freecores/amber/hw/vlog/system/main_mem.v

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

module main_mem#(
parameter WB_DWIDTH  = 32,
parameter WB_SWIDTH  = 4
)(
input                          i_clk,
input                          i_mem_ctrl,  // 0=128MB, 1=32MB
// Wishbone Bus
input       [31:0]             i_wb_adr,
input       [WB_SWIDTH-1:0]    i_wb_sel,
input                          i_wb_we,
output      [WB_DWIDTH-1:0]    o_wb_dat,
input       [WB_DWIDTH-1:0]    i_wb_dat,
input                          i_wb_cyc,
input                          i_wb_stb,
output                         o_wb_ack,
output                         o_wb_err

);

`include "memory_configuration.v"

reg     [127:0]     ram   [2**(MAIN_MSB-2)-1:0];
wire                start_write;
wire                start_read;
reg                 start_read_d1;
reg                 start_read_d2;
wire    [127:0]     rd_data;
wire    [127:0]     masked_wdata;

reg                 wr_en           = 'd0;
reg     [15:0]      wr_mask         = 'd0;
reg     [127:0]     wr_data         = 'd0;
reg     [27:0]      addr_d1         = 'd0;
wire                busy;
genvar              i;


assign start_write = i_wb_stb &&  i_wb_we && !busy;
assign start_read  = i_wb_stb && !i_wb_we && !busy;
assign busy        = start_read_d1 || start_read_d2;

assign o_wb_err    = 'd0;


generate
if (WB_DWIDTH == 128) 
    begin : wb128
    reg     [127:0]      wb_rdata128 = 'd0;

    // ------------------------------------------------------
    // Write for 32-bit wishbone
    // ------------------------------------------------------
    always @( posedge i_clk )
        begin
        wr_en          <= start_write;
        wr_mask        <= ~ i_wb_sel; 
        wr_data        <= i_wb_dat;

                          // Wrap the address at 32 MB, or full width
        addr_d1        <= i_mem_ctrl ? {5'd0, i_wb_adr[24:2]} : i_wb_adr[29:2];
        
        if ( wr_en )
            ram [addr_d1[27:2]]  <= masked_wdata;
        end


    for (i=0;i<16;i=i+1) begin : masked
        assign masked_wdata[8*i+7:8*i] = wr_mask[i] ? rd_data[8*i+7:8*i] : wr_data[8*i+7:8*i];
        end

        
    // ------------------------------------------------------
    // Read for 32-bit wishbone
    // ------------------------------------------------------
    assign rd_data = ram [addr_d1[27:2]];

    always @( posedge i_clk )
        begin
        start_read_d1   <= start_read;
        start_read_d2   <= start_read_d1;
        if ( start_read_d1 )
            begin
            wb_rdata128 <= rd_data;
            end
        end
    assign o_wb_dat = wb_rdata128 ;                  
    assign o_wb_ack = i_wb_stb && ( start_write || start_read_d2 );

    end
else
    begin : wb32
    reg     [31:0]      wb_rdata32 = 'd0;

    // ------------------------------------------------------
    // Write for 32-bit wishbone
    // ------------------------------------------------------
    always @( posedge i_clk )
        begin
        wr_en          <= start_write;
        wr_mask        <= i_wb_adr[3:2] == 2'd0 ? { 12'hfff, ~i_wb_sel          } : 
                          i_wb_adr[3:2] == 2'd1 ? { 8'hff,   ~i_wb_sel, 4'hf    } : 
                          i_wb_adr[3:2] == 2'd2 ? { 4'hf,    ~i_wb_sel, 8'hff   } : 
                                                  {          ~i_wb_sel, 12'hfff } ; 
        wr_data        <= {4{i_wb_dat}};

                          // Wrap the address at 32 MB, or full width
        addr_d1        <= i_mem_ctrl ? {5'd0, i_wb_adr[24:2]} : i_wb_adr[29:2];
        
        if ( wr_en )
            begin
            ram [addr_d1[27:2]]  <= masked_wdata;
            `ifdef AMBER_MEMIF_DEBUG
            $write("%09d  ", `U_TB.clk_count);
            $display("Main memory write: address %h, data %h, be %d%d%d%d",
                        {2'd0, addr_d1, 2'd0}, wr_data[31:0], 
                        ~wr_mask[addr_d1[1:0]*4+3],
                        ~wr_mask[addr_d1[1:0]*4+2],
                        ~wr_mask[addr_d1[1:0]*4+1],
                        ~wr_mask[addr_d1[1:0]*4+0]                        );
            `endif
            end
        end


    for (i=0;i<16;i=i+1) begin : masked
        assign masked_wdata[8*i+7:8*i] = wr_mask[i] ? rd_data[8*i+7:8*i] : wr_data[8*i+7:8*i];
        end
        
    // ------------------------------------------------------
    // Read for 32-bit wishbone
    // ------------------------------------------------------
    assign rd_data = ram [addr_d1[27:2]];

    always @( posedge i_clk )
        begin
        start_read_d1   <= start_read;
        start_read_d2   <= start_read_d1;
        if ( start_read_d1 )
            begin
            wb_rdata32 <= addr_d1[1:0] == 2'd0 ? rd_data[ 31: 0] :
                          addr_d1[1:0] == 2'd1 ? rd_data[ 63:32] :
                          addr_d1[1:0] == 2'd2 ? rd_data[ 95:64] :
                                                 rd_data[127:96] ;
            end
        end
    assign o_wb_dat = wb_rdata32 ;                  
    assign o_wb_ack = i_wb_stb && ( start_write || start_read_d2 );
    end
endgenerate


endmodule
