freecores/amber/(commit log)

2011-01-19 Corrected a couple of minor typos
2011-02-17 Bug fix - added an extra state to the rx state machine to properly align reading the uart input to the middle of each bit.
    [uart.v]
2011-02-17 Re-wrote the behavioral clock generation code to more accurately calculate the sys_clk frequency. The previous version was not producing the correct frequency at higher frequenies due to rounding err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
    [clocks_resets.v]
2011-02-19 Deleted the old version of the 3-state amber core. Its replaced with amber23. Added the 5-state Amber core.
    [a25_alu.v, a25_barrel_shift.v, a25_config_defines.v, a25_coprocessor.v, a25_core.v, a25_dcache.v, a25_decode.v, a25_decompile.v]
2011-02-21 amber25 core bug fix. The return address for irq interrupts was off by 4 bytes when the interrupt occurred during a stm instruction with the following instruction having some register conflicts. Adde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
    [a25_core.v, a25_dcache.v, a25_decode.v, a25_decompile.v, a25_icache.v, a25_wishbone.v, dumpvcd.v, system_config_defines.v]
2011-02-25 Create a configuration log file as part of the synthesis flow. This file is a useful reference to tell the different bitfiles apart.
2011-02-25 Added feature to A25 core to directly use a read value from the write back stage to reduce the stall to 1 cycle when there is a register conflict with the following instruction. This increases perfor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
    [a25_core.v, a25_decode.v, a25_execute.v]
2011-03-24 Bug fix: boot-loader.mem became larger that the allowed 8k byte boot mem size. Removed a struct in elfsplitter.c thats only used for debug - this reduced boot-loader.mem enough so that it fits again.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
    [elfsplitter.c]
2011-05-03 Moved function prototypes to .h file
2011-05-05 Bug fix - a write access was sometimes dropped when it was in a sequence of writes with variable wb_ack delays
    [a25_wishbone.v]
2011-05-19 Fixed bug in div assembly function. Handles negative numbers correctly. Fixed bug in printf function, negative numbers now print correctly.
2011-05-24 Added a second level of buffering to a25_wishbone_buf to fix a lockup bug when write acks to not return immediately, and also to improve performance slightly
    [a25_core.v, a25_dcache.v, a25_mem.v, a25_wishbone.v, a25_wishbone_buf.v]
2011-05-25 Added wishbone bus jitter testing option. Cleaned up waveform log .do files, now seperate files for a23 and a25 cores. Added vmlinux executable elf file for running on hardware.
    [boot_mem128.v, boot_mem32.v, system_config_defines.v]
2011-05-31 Added write buffer - fixes bug if wishbone writes takes multiple cycles to complete
    [a23_wishbone.v]
2011-06-18 Added support for the flat executable file format to vmlinux, so that the hello-world program is correctly relocated when it is loaded at the end of the vmlinux test. Changed the Virtex-5 clock confi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
    [a23_config_defines.v, clocks_resets.v, system_config_defines.v]
2011-07-16 Fixed a bug in linux that caused the os to not return to the running application after an interrupt. Hello-world now runs stand-alone again. Added initrd-200k-dhry, a disk image that uses the dhry pr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
    [boot-loader.h]
2011-09-14 Bug fix for bug reported by Botao Lee. The mode bits in the decode stage did not change immediately after a mode switch from a teqp instruction, but 1 cycle later. This meant the wrong set of registe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
    [a23_execute.v, a25_execute.v]
2011-12-10 Bug fix; removed a combinational loop from the a25_decode logic.
    [a25_dcache.v, a25_decode.v, a25_mem.v]
2013-04-28 Original Amber 23 core uses asyncronous implementation of register bank. It leads to some problems with ram-based implementation of the register bank, because at least Altera FPGAs uses syncronous ra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
    The patch exposes non-registered versions of register select signals to the
    register bank, so the bank can build address and latch it in the syncronous
    ram input register.
    The patch is a pre-requisite for ram-based register bank implementation on Altera FPGA.
    Contributed by Dmitry Tarnyagin <dmitry.tarnyagin@lockless.no>
    [a23_core.v, a23_decode.v, a23_execute.v]
2013-04-28 The patch introduces a new configuration option `A23_RAM_REGISTER_BANK, which controls instantiation of Amber 23 register bank. If the option is set, a ram-based variant of the register bank is insta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
    Altera Cyclone III resource utilization:
    - flipflop-based register bank: 1583 combinationals + 856 registers
    - ram-based register bank: 268 combinationals + 156 registers
    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
    [a23_config_defines.v, a23_execute.v, a23_ram_register_bank.v]
2013-04-28 The patch implements barrel shifter using rotate as a main primitive. The design was optimized for Altera Cyclone III FPGA and can be reused with other FPGA vendors and products. The patch integrates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
    The patch reduces footprint from 1178 to 339 LEs keeping Fmax at 57-60 MHz.
    Contributed by: Dmitry Tarnyagin <dmitry.tarnyagin@lockless.no>
2013-05-06 Added a serial debug port (using UART0) to boot-loader-ethmac
2013-05-20 Make the tcp functionality more like a normal sockets implementation.
