freecores/amber/(notices)

Notices in the files:
hw/vlog/ethmac/eth_top.v:
Copyright (C) 2001, 2002 Authors
hw/vlog/ethmac/eth_txstatem.v:
Copyright (C) 2001 Authors
hw/vlog/amber23/a23_barrel_shift_fpga.v:
Copyright (C) 2010-2013 Authors and OPENCORES.ORG
